fabioitturriet/CardIoT/firmware/ECG/TouchGFX/assets/images/__designer/Dark_Backgrounds_Main_bg_texture_480x272px.png

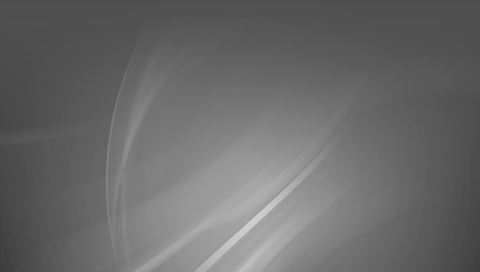
firmware/ECG/TouchGFX/assets/images/__designer/Dark_Backgrounds_Main_bg_texture_480x272px.png
