fabioitturriet/CardIoT/firmware/ECG/TouchGFX/assets/images/bateria.png

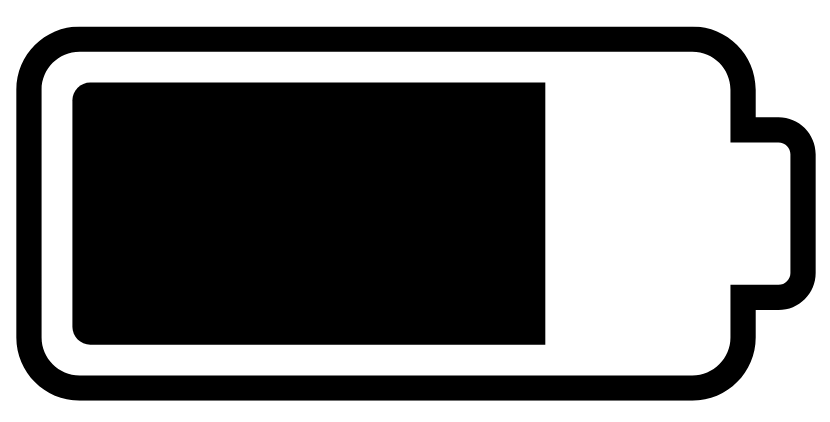
firmware/ECG/TouchGFX/assets/images/bateria.png
