fabioitturriet/CardIoT/firmware/ECG/TouchGFX/assets/images/deitadoedit.png

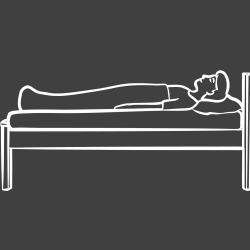
firmware/ECG/TouchGFX/assets/images/deitadoedit.png
