fabioitturriet/CardIoT/firmware/ECG/TouchGFX/assets/images/gelcondutoredit.png

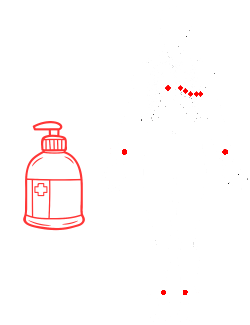
firmware/ECG/TouchGFX/assets/images/gelcondutoredit.png
