fabioitturriet/CardIoT/firmware/ECG/TouchGFX/assets/images/keyboard_background.png

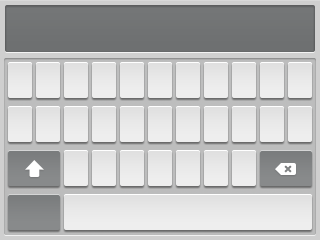
firmware/ECG/TouchGFX/assets/images/keyboard_background.png
