fabioitturriet/CardIoT/firmware/ECG/TouchGFX/assets/images/local_eletrodos_corpo.png

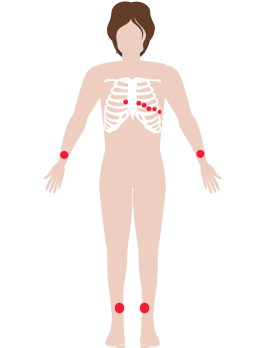
firmware/ECG/TouchGFX/assets/images/local_eletrodos_corpo.png
