fabioitturriet/CardIoT/firmware/ECG/TouchGFX/assets/images/local_eletrodos_peito.png

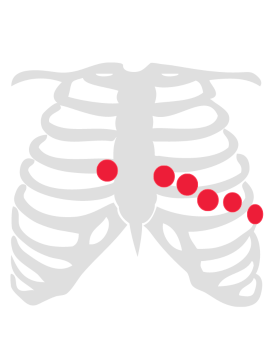
firmware/ECG/TouchGFX/assets/images/local_eletrodos_peito.png
