fabioitturriet/CardIoT/firmware/ECG/TouchGFX/assets/images/orientacaoedit.png

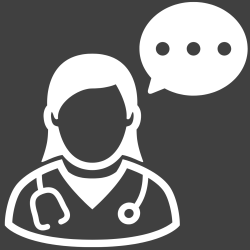
firmware/ECG/TouchGFX/assets/images/orientacaoedit.png
