fabioitturriet/CardIoT/firmware/ECG/TouchGFX/assets/images/VersaoVertical_resized.png

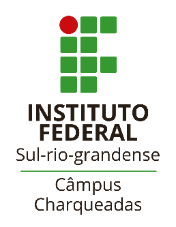
firmware/ECG/TouchGFX/assets/images/VersaoVertical_resized.png
