fabioitturriet/CardIoT/hardware/bom_V4.0.csv

ID | Name | Designator | Footprint | Quantity | Manufacturer Part | Manufacturer | Supplier | Supplier Part | Price
1 | 2pinsbarrette | H1 | 2PINSBARRETTE | 1 | 1125-1102G0R138C002 | Wcon | LCSC | C721441 | 0.021
2 | 10K | R12,R13,R15 | R0805 | 3 | AECR0805F10K0K9 | ResistorToday | LCSC | C328381 | 0.012
3 | SWITCH-DPDTAYZ0202 | S2 | AYZ0202 | 1
4 | CONECTOR ARDUINO R3 | U2 | ARDUINOR3 | 1
5 | 1nF | C14 | C0805 | 1 | CL21A226MPQNNNE | SAMSUNG | LCSC | C29277 | 0.082
6 | NI | C27 | C0805 | 1 | CL21B105KBFNNNE | SAMSUNG | LCSC | C28323 | 0.04
7 | 1N4148WS | D1,D2,D3,D4,D5,D6,D7,D8,D9,D10,D11,D12,D13,D14,D15,D16,D17,D18,D19,D20 | SOD-323_L1.8-W1.3-LS2.5-RD | 20 | 1N4148WS | Tak Cheong | LCSC | C112663 | 0.013
8 | 670K | R25 | R0805 | 1 | AECR0805F10K0K9 | ResistorToday | LCSC | C328381 | 0.012
9 | LP2985AIM5-5.0 | U4 | SOT-23-5_L3.0-W1.7-P0.95-LS2.8-BR | 1 | LP2985A-50DBVR | TI | LCSC | C109382 | 0.281
10 | NI | U5 | XTAL-7X5MM-C339X-2.048 | 1
11 | JST XH 3 | JP1 | JST-XH-03P-2.54MM | 1
12 | 10uF | C38,C39,C13,C19,C43 | C0805 | 5 | 0805X106K250NT | FH | LCSC | C40894 | 0.161
13 | 10nF | C44,C16 | C0805 | 2 | 0805B103K500NT | FH | LCSC | C52278 | 0.009
14 | 1uF | C45,C7,C9,C17,C18 | C0805 | 5 | CL21B105KBFNNNE | SAMSUNG | LCSC | C28323 | 0.04
15 | 3.3uH | L3,L1,L2 | L0805 | 3 | FERRITE220OHMDCR | SUNLORD | LCSC | C2909780
16 | ADS1198CPAGR | ADS1198 | TQFP-64_L10.0-W10.0-P0.50-LS12.0-BL | 1 | ADS1198CPAGR | Texas Instruments | LCSC | C544378 | 18.924
17 | 47pF | C1,C2,C3,C4,C5,C6,C21,C22,C23,C24,C28,C29,C30,C31,C32,C33,C34,C35,C36,C37 | C0805 | 20 | 0805CG470J500NT | FH | LCSC | C1821
18 | 100nF | C8,C12,C15,C26,C40 | C0805 | 5 | CL21B104JBCNNNC | SAMSUNG | LCSC | C62912 | 0.025
19 | 22uF | C10 | C0805 | 1 | CL21A226MPQNNNE | SAMSUNG | LCSC | C29277 | 0.082
20 | 100pF | C11 | C0805 | 1 | CC0805JRNPO9BN101 | YAGEO | LCSC | C62768 | 0.01
21 | 1uF | C20,C25,C41 | C0805 | 3 | 0805X106K250NT | FH | LCSC | C40894 | 0.161
22 | 10uF | C42 | C0805 | 1 | CL21B105KBFNNNE | SAMSUNG | LCSC | C28323 | 0.04
23 | JUMPER_SOLDER_1X2 | J1 | JUMPER_SOLDER_1X2 | 1
24 | D-G080508G1 | LED1 | LED0805-RD | 1 | D-G080508G1 | ARKLED | LCSC | C107402 | 0.024
25 | 22.1K | R1,R3,R5,R6,R8,R10,R17,R19,R21,R23 | R0805 | 10 | PTFR0805B100KP9 | Resistor.Today | LCSC | C478884 | 0.066
26 | 10K | R2,R4,R7,R9,R14,R16,R18,R20,R22,R24 | R0805 | 10 | PTFR0805B100KP9 | Resistor.Today | LCSC | C478884 | 0.066
27 | 330 | R11 | R0805 | 1 | RMCF0805JT330R | Stackpole Elec | LCSC | C237764 | 0.006
28 | DB15 | U1 | DSUB-TH_FDB1502-F0DB300K6KA | 1 | DB15 | null | LCSC | C9900014823
29 | LP2985A-33DBVR | U3 | SOT-23-5_L3.0-W1.7-P0.95-LS2.8-BR | 1 | LP2985A-33DBVR | TI | LCSC | C89826 | 0.351
