fabioitturriet/CardIoT/hardware/enclosure/case_v1_top.stl

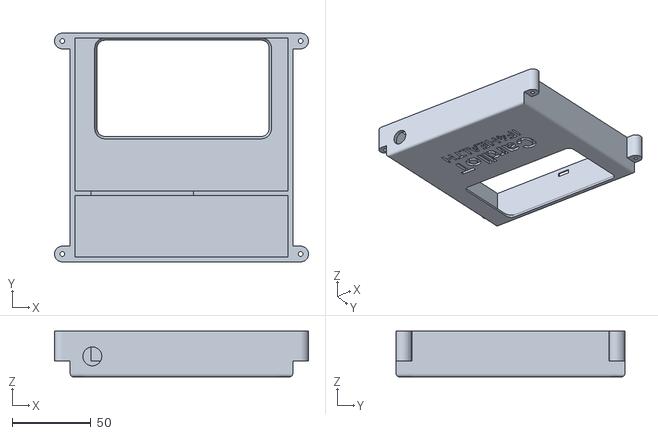
[picture p11: CAD file, 2026-10-11]
hardware/enclosure/case_v1_top.stl
161.0 x 145.0 x 29.0
