fabioitturriet/CardIoT/hardware/enclosure/case_v1_bottom.stl

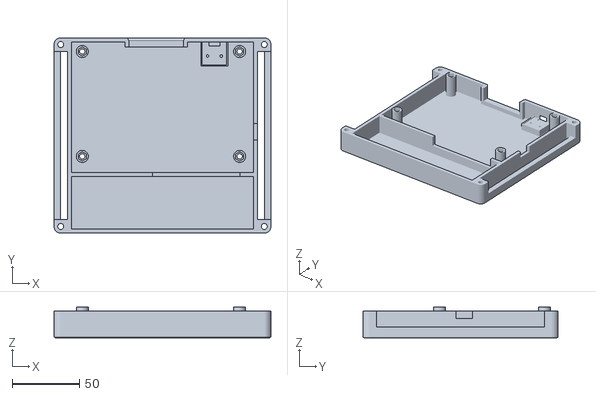
[picture p12: CAD file, 2026-10-11]
hardware/enclosure/case_v1_bottom.stl
161.0 x 145.0 x 22.7
