fabioitturriet/CardIoT/hardware/pcb-layout_V4.0.pdf

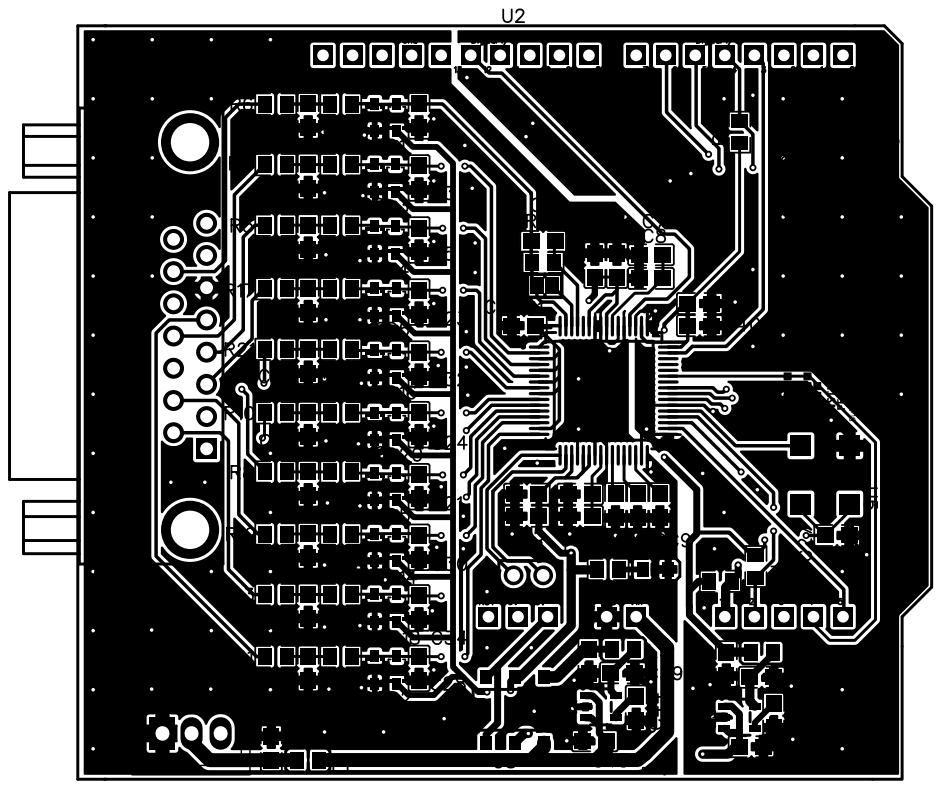
[picture p13: page 1]
