fabioitturriet/CardIoT/hardware/schematic_V4.0.pdf

## RLDOUT

## IN1P

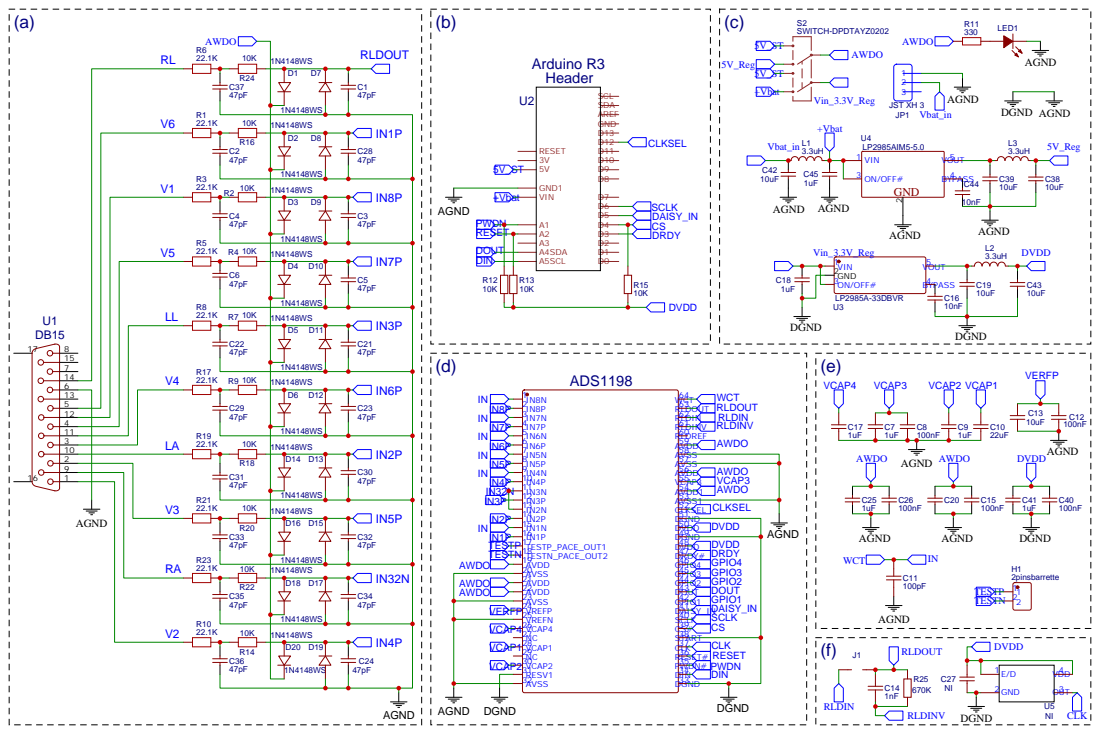
[picture p14: page 1]
